defane/FPV-5.8-Checkoint/docs/fleet.md

# Race-timing fleet (C6 master)

For a multi-gate race, an **ESP32-C6 master** (`firmware/master`) takes over the
C3's brain role and carries the speaker. Each **gate** is a C5; the master's C5
is UART-wired to the C6 (gate 0), the others are each wired to a **C3 node** that
relays over **ESP-NOW** to the C6.

Overall element/interaction diagram: [`fleet.svg`](fleet.svg). Pin-level wiring
per set type: [`wiring-master.svg`](wiring-master.svg) (C6 + C5),
[`wiring-node.svg`](wiring-node.svg) (C3 + C5; also a C3 + C5 with no master),
[`wiring-c5c5.svg`](wiring-c5c5.svg) (temporary C5+C5). Only the master carries
an amplifier; a gate C5 never does. Consolidated pinout: the
[README](../README.md#pinout).

**Temporary C5+C5 set** (until a C6 is available): a second C5 runs the master
firmware built for esp32c5 (`firmware/master`, target esp32c5). The amp moves to
the C5 pins 9/8/7/10 (GPIO 16‑22 are the C5 flash); UART stays 4/5. Build: `make
flash FW=master-wave-c5` (or `idf.py -DIDF_TARGET=esp32c5 -DSDKCONFIG=sdkconfig.c5
-DSDKCONFIG_DEFAULTS=sdkconfig.c5.defaults -B build-c5 build` from
`firmware/master`, → `build-c5/master-c5.bin`). Later swap that C5 for a real C6
with no change on the gate side.

- **Protocols:** `components/link_proto` v3 (C5↔bridge UART: `CONFIG_*`,
  `EVENT_PASS` with the pass's age, `STATS` with the 8 channels' levels and the C5's
  health, `COMMAND`); `components/fleet_proto` v3
  (C6↔C3 ESP-NOW: pairing, time beacons, `CONFIG`, `GATE_PASS`, `NODE_STATUS`
  relaying that, `COMMAND`); `components/espnow_link` (transport);
  `components/race_timing` (laps/sectors per channel). A board left on an older
  firmware is not misread, it simply does not talk: **reflash every C5, C3 and the
  C6 together** after a protocol change.
- **C6** (`c6_hub`): node table in NVS, periodic time beacons, the `race_timing`
  engine, **centralized sound**, and an **admin web** (AP) to pair, order the
  gates and see the timings. Every C5 sweeps R1 to R8, so a gate has no channel: a pass
  carries the channel it was seen on.
- **Pairing:** C6 web → *pairing open*; an unpaired C3 broadcasts a
  `PAIR_REQUEST`; the C6 assigns it a gate (`PAIR_ACCEPT` + `CONFIG`),
  persisted on both sides. The channel those frames still carry is ignored. A node only asks
  while it boots, so with pairing closed it ends up degraded: open pairing, then reboot it.
- **Degraded C3:** if the C6 is unreachable for `CONFIG_C3_FLEET_TIMEOUT_MS` at
  boot, the C3 serves its own local AP + web (pass display, the channels' levels,
  detector settings).
- **Simple and advanced:** the C6 page opens on what spectators came for, the standings
  and the last results. Each channel in the standings has its status: online while a pass is under 30 s old, else offline; hover or tap the badge
  for when it was last seen, on the master's clock. The advanced toggle adds the channels, the gates
  and the race controls; the choice stays on the device (browser storage). It changes
  the view only: the admin password still guards every action.
- **Last results** (both views, `GET /api/results`): a column per channel seen, with
  its last 10 laps, newest on top. A click on a row adds the lap numbers and the sectors
  gate to gate (`G0→1`, `G1→2`, then `G2→0` closing the lap); `—` next to a gate that
  missed the drone. The pause toggle holds the table for that viewer, with a badge per
  channel counting the laps it is behind (`reset` if the channel was reset meanwhile)
  until it is released. An admin can reset one channel (`POST /api/reset` `{"channel": N}`):
  its times and its lap in progress go, it stays listed with when it was last seen.
  *Reset all* (`{}`) clears the whole race, standings included.
- **Channels panel:** the C6 page shows one row per gate, the degraded C3 page one
  tile per channel, R1 to R8, with its level in dB above the channel's rest and a yellow
  mark on a pass; `—` while the C5 is away or calibrating. A VTX left on keeps showing.
- **Web roles:** two levels. A **spectator** sees timings/status read-only (no
  login); **admin** actions (pairing, gate order, reset, volume, a
  gate's calibration or reboot; detector tuning on a degraded
  C3) need the admin password (`CONFIG_*_ADMIN_PASSWORD`, no
  username, any length): the header's admin toggle opens a password
  dialog; turning it off forgets it. An empty password disables
  admin auth. See "Signed admin requests" below.
- **Signed admin requests** (`components/web_auth`): the password never crosses
  the Wi-Fi and the firmware never holds it. The build turns it into
  K = PBKDF2-HMAC-SHA256(password, salt, 200000), 32 bytes in `admin_hash.h`,
  with a salt `fpv58-checkpoint/<c3|c6>/<16 hex>` random at each configure
  (`components/web_auth/project_include.cmake`, `admin_key.py`). At login the page
  opens a session (`POST /api/session`: a random 128-bit id from the hardware RNG,
  plus the salt and the iterations) and derives the same K from the typed password
  (`/auth.js`, pure-JS SHA-256/HMAC/PBKDF2, since browsers keep `crypto.subtle` for
  HTTPS: about 0.1 s on a desktop, 0.3–1 s on a phone, once per login, the dialog
  showing "checking…"; the ESP never runs the derivation). Every admin request
  then carries `X-Auth-Session`,
  `X-Auth-Seq` (1, 2, 3… per session) and `X-Auth-Sig` = HMAC-SHA256(K, sid `\n`
  seq `\n` method `\n` path `\n` body). The ESP accepts each seq once and only in
  increasing order, so a captured request replayed, or one with a changed body or
  path, is refused. Sessions live in RAM (4, least recently used evicted): after
  an ESP reboot the page reopens one with K, without asking for the password
  again. The page sends one request at a time and gives up on each HTTP exchange
  after 10 s (one that must reopen its session can take up to 30 s). On logout,
  or when the login dialog is closed during a login, queued requests are dropped;
  one already sent may still have run on the ESP and its reply reaches its
  caller, but nothing started before the logout is re-signed or retried after
  it, and a late refusal no longer logs the next login out. Limits:
  - a listener on the AP (it shares one Wi-Fi password with every spectator, or
    is open) who captures a single signed request, and every login sends one, can
    test password guesses offline; PBKDF2 makes each guess cost 200000 HMACs, but
    a short or common password still falls: use a long random one (the default
    `checkpoint` is public);
  - plain HTTP still lets an *active* attacker on the AP serve a modified page
    that reads the password as it is typed (only HTTPS prevents that);
  - anyone with the `.bin` holds K and can sign without the password;
  - anyone on the AP can force sessions to be reopened.
- **Constraint:** the C6 and C3 APs **and** ESP-NOW share the **same Wi-Fi
  channel** (`CONFIG_*_AP_CHANNEL` / `CONFIG_C6_AP_CHANNEL`).
- **Limit:** the time base (ESP-NOW beacons) aims for ~10 ms; not a sub-ms photo
  finish. A pass is timed at its peak by the C5, and a lap by gate 0's C5 alone. A sector
  also depends on when a remote gate's pass reaches its C3, after a 100 ms UART poll
  (`LINK_READ_MS`): count ±0.1 s on it for now. The first passes after a boot teach the
  master the local C5's clock, so a lap there can read a little short.

## Gate health and remote commands (no console in production)

Nobody opens a detector C5's USB console in production, so everything an operator
needs from it goes through its bridge: the C6 admin web for the fleet (gate 0 is
its own C5 over UART, the others go through their C3), or the degraded C3's own
page for a gate with no master.

- **Health**, from the C5's `STATS` every `CONFIG_CHECKPOINT_LINK_STATS_MS`
  (relayed in `NODE_STATUS`): a calibration badge (OK / calibration needed, i.e.
  `CAL_NEEDED`/`DC_FAULT` / calibrating), RX gain, passes since boot, C5 uptime,
  lowest free heap, transport fault counters and the firmware id. A C5 silent for
  **3 s** is shown as absent: no stale health, and commands to it fail.
- **Commands** (admin): *Cal B* = the console's `B` (full RF optimisation),
  *Cal F* = `F` (quick filter calibration), *Reboot*; on the C6 also *Calibrate
  all gates (B)*. They call the same engine functions as the console
  (`filter_request_full()`, `filter_request()`), so the engine still refuses a
  calibration that is already running.
- **Guard:** a calibration blinds the gate for minutes and wants the VTXs off.
  The page asks for confirmation; then the bridge refuses, unless forced, any
  gate whose strongest channel is above that C5's activity threshold (`active_db`,
  read from its `CONFIG_STATE` echo), i.e. a VTX is probably on. The C6 also skips gates
  already calibrating (listed as *busy*); the C3 page disables its calibration
  buttons meanwhile. Reboot is not VTX-guarded.
- **API:** C6 `POST /api/command` `{"gate": 0..15 | -1 (all), "cmd": "cal_full" |
  "cal_quick" | "reboot", "force": 0|1}` → `{"ok": true, "sent": [...], "failed":
  [...], "busy": [...]}` or `{"ok": false, "vtx": [{"gate": g, "cn_x10": x}]}`. The
  degraded C3's `POST /api/command` `{"cmd": ..., "force": 0|1}` (its one gate)
  replies `{"ok": true}`, `{"ok": false, "vtx": true, "cn_x10": x}` or
  `{"ok": false, "msg": "no C5 linked"}`.
- **Back online:** the C6 re-sends a node's `CONFIG` (gate, detector settings) when the
  node comes back online, so a rebooted gate returns to its assignment.
