defane/FPV-5.8-Checkoint/hardware/checkpoint-master/checkpoint-master-1to1.pdf

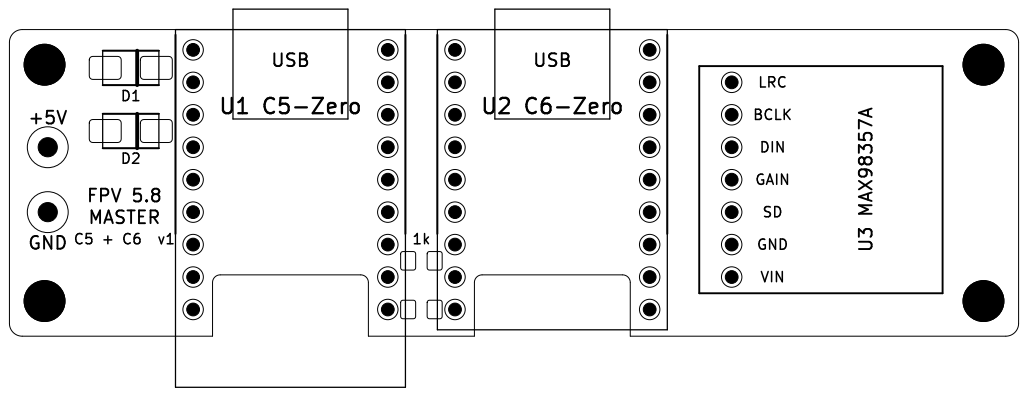
[picture p2: page 1]
