defane/FPV-5.8-Checkoint/hardware/checkpoint-node/checkpoint-node-1to1.pdf

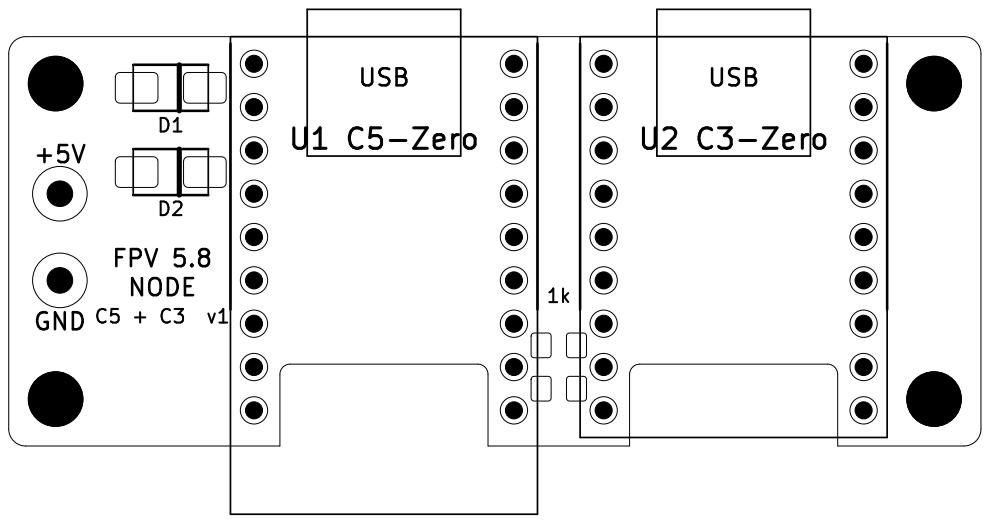
[picture p3: page 1]
