defane/FPV-5.8-Checkoint/hardware/checkpoint-node/checkpoint-node.kicad_pcb

## KiCad design hardware/checkpoint-node/checkpoint-node.kicad_pcb (2026-11-07)

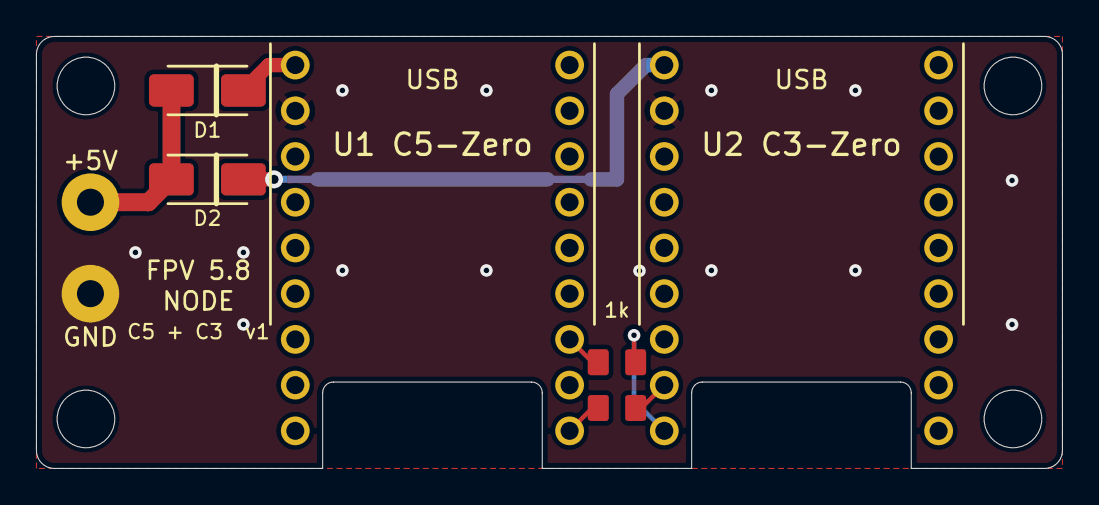
[picture p4: board checkpoint-node.kicad_pcb from above]

Board: 2 copper layers, 57.0 x 24.0 mm, 12 parts (0 on the bottom side), 8 nets.

Parts:
D1, D2: SS34 3A 40V SMA; SS34
H1, H2, H3, H4: M3 hole; M3
J1: +5V wire pad; +5V
J2: GND wire pad; GND
R1, R2: 1k 0805; 1k
U1: C5-Zero
U2: C3-Zero

Connections:
5V_BRIDGE: D2.1, U2.5V
5V_C5: D1.1, U1.5V
+5V: D1.2, D2.2, J1.1
BRIDGE_RX: R1.2, U2.4
BRIDGE_TX: R2.2, U2.5
C5_RX: R2.1, U1.8
C5_TX: R1.1, U1.6
GND: J2.1, U1.GND, U2.GND
