defane/FPV-5.8-Checkoint/firmware/master/main/c6_web.c

#include "c6_web.h"
#include "admin_hash.h"
#include "c6_hub.h"
#include "c6_store.h"
#include "esp_http_server.h"
#include "esp_log.h"
#include "sdkconfig.h"
#include "web_auth_esp.h"
#include <stdio.h>
#include <stdlib.h>
#include <string.h>

static const char *TAG = "c6_web";

extern const uint8_t index_html_start[] asm("_binary_index_html_start");
extern const uint8_t index_html_end[]   asm("_binary_index_html_end");

static esp_err_t get_root(httpd_req_t *req) {
    httpd_resp_set_type(req, "text/html");
    return httpd_resp_send(req, (const char *)index_html_start,
                           index_html_end - index_html_start - 1);
}

/* Snapshots for the handlers: too large for the httpd stack (c6_fleet_t is
 * ~1.5 KB), and httpd runs one handler at a time. */
static c6_snapshot_t s_snap;
static c6_fleet_t    s_fleet;
static race_timing_t s_results;

/* A C5's firmware id is foreign text: keep it inert in the JSON and in the
 * page's HTML (printable ASCII minus quotes, backslash and markup). */
static const char *safe_fw(const char *fw, char out[LP_FW_LEN]) {
    unsigned i = 0;
    for (; i + 1u < LP_FW_LEN && fw[i]; i++)
        out[i] = (fw[i] >= 0x20 && fw[i] < 0x7f && !strchr("\"\\<>&'", fw[i])) ? fw[i] : '?';
    out[i] = '\0';
    return out;
}

/* The C5 health fields shared by "local" and each node. */
static int put_health(char *b, size_t cap, uint32_t passes, uint8_t flags, uint8_t gain,
                      uint32_t uptime_s, uint32_t heap_min, uint32_t faults, const char *fw) {
    char f[LP_FW_LEN];
    return snprintf(b, cap, "\"passes\":%lu,\"cal_needed\":%s,\"calibrating\":%s,\"gain\":%u,"
                    "\"c5_uptime_s\":%lu,\"heap_min\":%lu,\"faults\":%lu,\"fw\":\"%s\"",
                    (unsigned long)passes, (flags & LP_HEALTH_CAL_NEEDED) ? "true" : "false",
                    (flags & LP_HEALTH_CALIBRATING) ? "true" : "false", gain,
                    (unsigned long)uptime_s, (unsigned long)heap_min, (unsigned long)faults,
                    safe_fw(fw, f));
}

/* One level per Raceband channel, dB x10, LP_CN_UNKNOWN when not measured. */
static int put_levels(char *b, size_t cap, const int8_t *levels) {
    int o = snprintf(b, cap, "\"levels\":[");
    for (unsigned ch = 0; ch < LP_LEVELS; ch++) {
        const bool known = levels && levels[ch] != LP_LEVEL_UNKNOWN;
        o += snprintf(b + o, cap - o, "%s%d", ch ? "," : "", known ? levels[ch] * 10 : LP_CN_UNKNOWN);
    }
    return o + snprintf(b + o, cap - o, "],");
}

static esp_err_t get_state(httpd_req_t *req) {
    c6_store_snapshot(&s_snap);
    c6_hub_snapshot(&s_fleet);
    const c6_snapshot_t *s = &s_snap;
    const c6_fleet_t *f = &s_fleet;

    /* Worst case (every field at its widest) 9996 B: levels 59 x 16 gates, last_seen_ms
     * 25 x 8 standings, header + local 394,
     * 15 nodes x 392, 8 standings 838, 24 passes 1739; sized so it never truncates. */
    static char body[10240];   /* larger than the stack; this handler is serialised by httpd */
    const lp_stats_t *l = &s->local;
    int o = 0;
    o += snprintf(body + o, sizeof body - o,
                  "{\"pairing\":%s,\"num_gates\":%u,\"has_local\":%s,"
                  "\"local\":{\"channel\":%u,\"cn_x10\":%ld,\"state\":%u,",
                  f->pairing ? "true" : "false", f->num_gates, s->has_local ? "true" : "false",
                  l->channel, (long)l->cn_x10, l->state);
    o += put_levels(body + o, sizeof body - o, s->has_local ? l->levels : NULL);
    o += put_health(body + o, sizeof body - o, l->passes, l->flags, l->gain, l->uptime_s,
                    l->heap_min, l->faults, l->fw);
    o += snprintf(body + o, sizeof body - o,
                  "},\"total_passes\":%lu,\"volume\":%u,"
                  "\"uptime_ms\":%lu,\"free_heap\":%lu,\"heap_total\":%lu,",
                  (unsigned long)s->total_passes, (unsigned)f->volume,
                  (unsigned long)f->uptime_ms, (unsigned long)f->free_heap,
                  (unsigned long)f->heap_total);

    o += snprintf(body + o, sizeof body - o, "\"nodes\":[");
    for (unsigned i = 0; i < f->num_nodes && o < (int)sizeof body; i++) {
        const c6_node_t *n = &f->nodes[i];
        o += snprintf(body + o, sizeof body - o,
                      "%s{\"node_id\":%u,\"gate\":%u,\"channel\":%u,\"online\":%s,\"cn_x10\":%ld,"
                      "\"state\":%u,\"last_seen_ms\":%lu,\"rssi\":%d,\"rx_frames\":%lu,"
                      "\"status_rx\":%lu,\"status_lost\":%lu,"
                      "\"mac\":\"%02x:%02x:%02x:%02x:%02x:%02x\",",
                      i ? "," : "", n->node_id, n->gate_index, n->channel,
                      n->online ? "true" : "false", (long)n->cn_x10,
                      n->state, (unsigned long)n->last_seen_ms,
                      (int)n->rssi, (unsigned long)n->rx_frames,
                      (unsigned long)n->status_rx, (unsigned long)n->status_lost,
                      n->mac[0], n->mac[1], n->mac[2], n->mac[3], n->mac[4], n->mac[5]);
        o += put_levels(body + o, sizeof body - o, n->online ? n->levels : NULL);
        o += put_health(body + o, sizeof body - o, n->passes, n->flags, n->gain, n->c5_uptime_s,
                        n->heap_min, n->faults, n->fw);
        o += snprintf(body + o, sizeof body - o, "}");
    }
    o += snprintf(body + o, sizeof body - o, "],\"standings\":[");
    for (unsigned i = 0; i < f->num_standings && o < (int)sizeof body; i++) {
        const c6_standing_t *st = &f->standings[i];
        o += snprintf(body + o, sizeof body - o,
                      "%s{\"channel\":%u,\"laps\":%lu,\"last_lap_ms\":%lu,\"best_lap_ms\":%lu,\"last_gate\":%d,"
                      "\"last_seen_ms\":%lu}",
                      i ? "," : "", st->channel, (unsigned long)st->laps,
                      (unsigned long)st->last_lap_ms, (unsigned long)st->best_lap_ms, st->last_gate,
                      (unsigned long)st->last_seen_ms);
    }
    o += snprintf(body + o, sizeof body - o, "],\"passes\":[");
    for (unsigned i = 0; i < s->n_passes && o < (int)sizeof body; i++)
        o += snprintf(body + o, sizeof body - o,
                      "%s{\"gate\":%u,\"channel\":%u,\"peak_db_x10\":%ld,\"at_ms\":%lu}",
                      i ? "," : "", s->passes[i].gate, s->passes[i].channel,
                      (long)s->passes[i].peak_db_x10, (unsigned long)s->passes[i].at_ms);
    o += snprintf(body + o, sizeof body - o, "]}");

    httpd_resp_set_type(req, "application/json");
    return httpd_resp_send(req, body, o);
}

/* Each channel's last laps, a chunk per channel: 8 full ones reach 18 KB. */
static esp_err_t get_results(httpd_req_t *req) {
    c6_hub_results(&s_results);
    const race_timing_t *rt = &s_results;
    /* Worst chunk (16 gates, every number at its widest) 2244 B: header 28, channel 24,
     * 10 laps x 219, closing 2; sized so it never truncates. */
    static char body[2304];   /* larger than the stack; this handler is serialised by httpd */
    httpd_resp_set_type(req, "application/json");
    int o = snprintf(body, sizeof body, "{\"num_gates\":%u,\"channels\":[", rt->cfg.num_gates);
    for (unsigned i = 0; i < rt->num_channels; i++) {
        const rt_channel_t *c = &rt->ch[i];
        o += snprintf(body + o, sizeof body - o, "%s{\"channel\":%u,\"laps\":[", i ? "," : "", c->channel);
        const rt_lap_t *lap;
        for (unsigned age = 0; (lap = rt_recent_lap(c, age)) != NULL; age++) {
            o += snprintf(body + o, sizeof body - o, "%s{\"number\":%lu,\"lap_ms\":%lu,\"splits\":[",
                          age ? "," : "", (unsigned long)lap->number, (unsigned long)lap->lap_ms);
            for (unsigned g = 1; g < rt->cfg.num_gates; g++)
                o += snprintf(body + o, sizeof body - o, "%s%lu", g > 1 ? "," : "", (unsigned long)lap->split_ms[g]);
            o += snprintf(body + o, sizeof body - o, "]}");
        }
        o += snprintf(body + o, sizeof body - o, "]}");
        if (httpd_resp_send_chunk(req, body, o) != ESP_OK) return ESP_FAIL;
        o = 0;
    }
    o += snprintf(body + o, sizeof body - o, "]}");
    if (httpd_resp_send_chunk(req, body, o) != ESP_OK) return ESP_FAIL;
    return httpd_resp_send_chunk(req, NULL, 0);
}

/* Tiny parser for the flat integer objects our own client POSTs. */
static int32_t json_i(const char *body, const char *key, int32_t def) {
    char pat[40];
    snprintf(pat, sizeof pat, "\"%s\"", key);
    const char *p = strstr(body, pat);
    if (!p) return def;
    p = strchr(p + strlen(pat), ':');
    if (!p) return def;
    p++;
    while (*p == ' ' || *p == '\t') p++;
    char *end;
    const long v = strtol(p, &end, 10);
    return end == p ? def : (int32_t)v;
}

/* Same for a "key":"value" string; false if absent or longer than out[cap]. */
static bool json_s(const char *body, const char *key, char *out, size_t cap) {
    char pat[40];
    snprintf(pat, sizeof pat, "\"%s\"", key);
    const char *p = strstr(body, pat);
    if (!p || !(p = strchr(p + strlen(pat), ':'))) return false;
    p++;
    while (*p == ' ' || *p == '\t') p++;
    if (*p++ != '"') return false;
    size_t n = 0;
    while (*p && *p != '"' && n + 1u < cap) out[n++] = *p++;
    out[n] = '\0';
    return *p == '"';
}

static esp_err_t ok_json(httpd_req_t *req, bool ok) {
    httpd_resp_set_type(req, "application/json");
    return httpd_resp_sendstr(req, ok ? "{\"ok\":true}" : "{\"ok\":false}");
}

/* ---- admin auth (spectators are read-only; admin actions are signed) ---- */
/* Every admin request is signed in the page with K = PBKDF2(password, ADMIN_SALT,
 * ADMIN_ITERATIONS), the only form of the password the firmware holds (admin_hash.h,
 * generated at build time by web_auth_admin_key()); components/web_auth checks the signature,
 * the session and its replay counter. web_auth_request() also reads the body:
 * on false its 400/401 is already sent. */
static const uint8_t s_admin_key[] = ADMIN_KEY;

static esp_err_t get_auth(httpd_req_t *req) {
    char buf[8];
    if (!web_auth_request(req, buf, sizeof buf)) return ESP_OK;
    httpd_resp_set_type(req, "application/json");
    return httpd_resp_sendstr(req, "{\"admin\":true}");
}

static esp_err_t post_pairing(httpd_req_t *req) {
    char buf[128];
    if (!web_auth_request(req, buf, sizeof buf)) return ESP_OK;
    c6_hub_set_pairing(json_i(buf, "open", 0) != 0);
    return ok_json(req, true);
}

static esp_err_t post_node(httpd_req_t *req) {
    char buf[128];
    if (!web_auth_request(req, buf, sizeof buf)) return ESP_OK;
    bool ok = c6_hub_set_node((uint8_t)json_i(buf, "node_id", -1),
                              (uint8_t)json_i(buf, "gate", 0),
                              (uint8_t)json_i(buf, "channel", 0));
    return ok_json(req, ok);
}

static esp_err_t post_node_remove(httpd_req_t *req) {
    char buf[128];
    if (!web_auth_request(req, buf, sizeof buf)) return ESP_OK;
    return ok_json(req, c6_hub_remove_node((uint8_t)json_i(buf, "node_id", -1)));
}

static esp_err_t post_reset(httpd_req_t *req) {
    char buf[16];   /* "{}" for the race, {"channel":255} for one: signed like any body */
    if (!web_auth_request(req, buf, sizeof buf)) return ESP_OK;
    const int32_t channel = json_i(buf, "channel", -1);
    if (channel >= 0) return ok_json(req, c6_hub_reset_channel((uint8_t)channel));
    c6_hub_reset_race();
    return ok_json(req, true);
}

static esp_err_t post_volume(httpd_req_t *req) {
    char buf[128];
    if (!web_auth_request(req, buf, sizeof buf)) return ESP_OK;
    c6_hub_set_volume((uint8_t)json_i(buf, "volume", 60));
    return ok_json(req, true);
}

/* A JSON array of the gates set in mask. */
static int put_gates(char *b, size_t cap, uint32_t mask) {
    int o = snprintf(b, cap, "[");
    for (unsigned g = 0; g < RT_MAX_GATES; g++)
        if (mask >> g & 1u)
            o += snprintf(b + o, cap - o, "%s%u", (mask & ((1u << g) - 1u)) ? "," : "", g);
    return o + snprintf(b + o, cap - o, "]");
}

static const struct { const char *name; lp_cmd_t cmd; } k_cmds[] = {
    { "cal_full", LP_CMD_CAL_FULL }, { "cal_quick", LP_CMD_CAL_QUICK }, { "reboot", LP_CMD_REBOOT },
};

/* The C5 console's B / F / reset for gates nobody plugs USB into.
 * {"gate":0..15, -1 = every reachable gate, "cmd":"cal_full"|"cal_quick"|"reboot",
 * "force":0|1}. A calibration blinds the gate for its duration and wants every
 * VTX off: unless forced, a target already seeing a C/N above its active_db (a
 * VTX probably on) blocks the whole request and is listed in "vtx" for the admin
 * to confirm and force. Otherwise each target goes to "sent" or "failed", and
 * for a calibration a gate already calibrating (its C5 would refuse, on its USB
 * console only) is not sent but listed in "busy". */
static esp_err_t post_command(httpd_req_t *req) {
    char buf[128], name[16];
    if (!web_auth_request(req, buf, sizeof buf)) return ESP_OK;
    const int32_t gate = json_i(buf, "gate", -2);
    lp_cmd_t cmd = 0;
    if (json_s(buf, "cmd", name, sizeof name))
        for (unsigned i = 0; i < sizeof k_cmds / sizeof k_cmds[0]; i++)
            if (strcmp(name, k_cmds[i].name) == 0) cmd = k_cmds[i].cmd;
    if (!cmd || gate < -1 || gate >= (int32_t)RT_MAX_GATES) {
        httpd_resp_send_err(req, HTTPD_400_BAD_REQUEST, "cmd/gate"); return ESP_FAIL;
    }

    /* Targets as a gate mask (a gate shared by two nodes is one target), the
     * strongest C/N each one sees now and the gates already calibrating; an
     * offline node's or an absent local C5's last C/N and flags are stale (an
     * absent gate 0 asked by name lands in "failed"). */
    c6_store_snapshot(&s_snap);
    c6_hub_snapshot(&s_fleet);
    int32_t cn[RT_MAX_GATES];
    for (unsigned g = 0; g < RT_MAX_GATES; g++) cn[g] = LP_CN_UNKNOWN;
    uint32_t busy = 0;
    if (s_snap.has_local) {
        cn[0] = s_snap.local.cn_x10;
        if (s_snap.local.flags & LP_HEALTH_CALIBRATING) busy |= 1u;
    }
    uint32_t targets = (gate == 0 || (gate == -1 && s_snap.has_local)) ? 1u : 0u;
    bool known = gate <= 0;                    /* gate 0 is always the master's own */
    for (unsigned i = 0; i < s_fleet.num_nodes; i++) {
        const c6_node_t *n = &s_fleet.nodes[i];
        if (n->gate_index >= RT_MAX_GATES) continue;
        if (n->gate_index == gate) { known = true; targets |= 1u << gate; }
        if (!n->online) continue;
        if (gate == -1) targets |= 1u << n->gate_index;
        if (n->cn_x10 > cn[n->gate_index]) cn[n->gate_index] = n->cn_x10;
        if (n->flags & LP_HEALTH_CALIBRATING) busy |= 1u << n->gate_index;
    }
    if (!known) { httpd_resp_send_err(req, HTTPD_400_BAD_REQUEST, "gate"); return ESP_FAIL; }
    busy = cmd == LP_CMD_REBOOT ? 0u : busy & targets;   /* a reboot still reaches a busy C5 */
    targets &= ~busy;

    char out[640];   /* worst case: 16 vtx entries x 34 B */
    int o;
    uint32_t vtx = 0;
    /* Gate 0's own C5 tells its active_db; remote gates run the one the hub pushes. */
    const int32_t vtx_x10 = c6_hub_vtx_threshold_x10();
    const int32_t vtx0_x10 = s_snap.has_local_cfg ? s_snap.local_cfg.active_db_x10 : vtx_x10;
    if (cmd != LP_CMD_REBOOT && json_i(buf, "force", 0) == 0)
        for (unsigned g = 0; g < RT_MAX_GATES; g++)
            if ((targets >> g & 1u) && cn[g] != LP_CN_UNKNOWN && cn[g] > (g ? vtx_x10 : vtx0_x10))
                vtx |= 1u << g;
    if (vtx) {
        o = snprintf(out, sizeof out, "{\"ok\":false,\"vtx\":[");
        for (unsigned g = 0; g < RT_MAX_GATES; g++)
            if (vtx >> g & 1u)
                o += snprintf(out + o, sizeof out - o, "%s{\"gate\":%u,\"cn_x10\":%ld}",
                              (vtx & ((1u << g) - 1u)) ? "," : "", g, (long)cn[g]);
        o += snprintf(out + o, sizeof out - o, "]}");
        ESP_LOGW(TAG, "command %s gate %ld held: strong signal on gates 0x%04lx", name, (long)gate,
                 (unsigned long)vtx);
    } else {
        uint32_t sent = 0, failed = 0;
        for (unsigned g = 0; g < RT_MAX_GATES; g++)
            if (targets >> g & 1u) {
                if (c6_hub_send_command((uint8_t)g, cmd)) sent |= 1u << g;
                else failed |= 1u << g;
            }
        o = snprintf(out, sizeof out, "{\"ok\":true,\"sent\":");
        o += put_gates(out + o, sizeof out - o, sent);
        o += snprintf(out + o, sizeof out - o, ",\"failed\":");
        o += put_gates(out + o, sizeof out - o, failed);
        o += snprintf(out + o, sizeof out - o, ",\"busy\":");
        o += put_gates(out + o, sizeof out - o, busy);
        o += snprintf(out + o, sizeof out - o, "}");
        ESP_LOGI(TAG, "command %s gate %ld: sent 0x%04lx failed 0x%04lx busy 0x%04lx", name,
                 (long)gate, (unsigned long)sent, (unsigned long)failed, (unsigned long)busy);
    }
    httpd_resp_set_type(req, "application/json");
    return httpd_resp_send(req, out, o);
}

void c6_web_start(void) {
    web_auth_init(s_admin_key, ADMIN_SALT, ADMIN_ITERATIONS, ADMIN_AUTH_OPEN);
    httpd_config_t cfg = HTTPD_DEFAULT_CONFIG();
    cfg.lru_purge_enable = true;
    cfg.max_uri_handlers = 12;   /* 10 here + web_auth's 2 */
    cfg.stack_size = 6144;       /* the signature's PSA HMAC under post_command: ~3.5 KB of the 4 KB default */
    httpd_handle_t srv = NULL;
    if (httpd_start(&srv, &cfg) != ESP_OK) { ESP_LOGE(TAG, "httpd start failed"); return; }
    const httpd_uri_t uris[] = {
        { .uri = "/",             .method = HTTP_GET,  .handler = get_root },
        { .uri = "/api/state",    .method = HTTP_GET,  .handler = get_state },
        { .uri = "/api/results",  .method = HTTP_GET,  .handler = get_results },
        { .uri = "/api/auth",     .method = HTTP_GET,  .handler = get_auth },
        { .uri = "/api/pairing",  .method = HTTP_POST, .handler = post_pairing },
        { .uri = "/api/node",     .method = HTTP_POST, .handler = post_node },
        { .uri = "/api/node_remove", .method = HTTP_POST, .handler = post_node_remove },
        { .uri = "/api/reset",    .method = HTTP_POST, .handler = post_reset },
        { .uri = "/api/volume",   .method = HTTP_POST, .handler = post_volume },
        { .uri = "/api/command",  .method = HTTP_POST, .handler = post_command },
    };
    for (unsigned i = 0; i < sizeof uris / sizeof uris[0]; i++) httpd_register_uri_handler(srv, &uris[i]);
    web_auth_register(srv);   /* POST /api/session, GET /auth.js */
    ESP_LOGI(TAG, "admin web on http://192.168.4.1/");
}
