defane/FPV-5.8-Checkoint/(commit log)

2026-10-29 feat(audio): add reproducible coin sound conversion
    tools/coin_sound.py turns assets/coin_source.mp3 (Pixabay, KRNBEATZ,
    not versioned) into mono 22050 Hz s16le PCM: silence trimmed, 2 ms
    fade-in, 10 ms fade-out, peak-normalised to -3 dBFS in a second pass.
    --check verifies the committed PCM.
2026-10-29 feat(audio_player): add low-priority I2S coin player
    New isolated component: MAX98357A on i2s_std, mono 22050 Hz s16, one
    priority-1 task fed by a queue of at most two requests (oldest dropped),
    per-request pitch by linear-interpolation resampling, software volume
    (60 % default), mute, SD high before a sound and low 50 ms after.
    The I2S channel (and its GDMA TX channel) is created per burst of sounds
    and deleted afterwards: transport.c's quiet_interrupts() disables the
    interrupts of all three GDMA channels on every transport restart, which
    would otherwise stall a long-lived I2S channel. No allocation while
    samples are written; the PCM is read from flash.
    Disabled by default (CONFIG_AUDIO_P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
    [audio_player.c, audio_player.h, audio_resample.h, test_audio_resample.c]
2026-10-29 feat(detector): add per-channel drone pass detector
    Pure C component (no hardware): exponential smoothing and an
    IDLE -> RISING -> PEAK_PASSED -> COOLDOWN machine per channel. A pass
    rings when the level falls drop_db (3 dB) under its maximum and that
    maximum reached min_peak_db; per-channel refractory period (1.5 s) and
    re-arm only once the level is back under the activity threshold minus
    hysteresis, so a hovering drone rings once. Stale channels return to
    IDLE. All thresholds in one pd_config_t.
    Host test test/test_pass_detector.c (in CI): clean and noisy pass,
    two drones on two channels, hovering drone, noise under the threshold,
    far drone, two laps, refractory, stale input, ms wraparoun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
    [test_pass_detector.c]
2026-10-29 feat: integrate pass detection on the tuned channel
    main/checkpoint.c: a priority-1 task (under every receiver task) reads
    the noise-referenced C/N (receiver_obs_cn_x10, dB) every 50 ms, feeds
    the pass detector with the tuned channel's number in its band and
    prints a PASS line per pass; with an audio build it queues the coin at
    that channel's pentatonic pitch. No sample while the menu, scan,
    calibration or a pause owns the receiver, or while the C/N is unknown;
    a retune resets the detector. Read-only on the receiver chain.
    Started after the boot splash with heap state, so nothing is added to
    the ~2 KB boot memory peak. The audio build refuses amplifier pins the
    receiver owns (IQ loopback fr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
    [audio_player.c, checkpoint.c, checkpoint.h, main.c]
2026-10-29 feat(console): add checkpoint play, mute and detector keys
    P plays the coin at the tuned channel's pitch, p toggles the sound, K
    opens a 5 s settings window (re-armed per key, q closes) like S:
    a/A alpha, t/T activity threshold, h/H hysteresis, d/D drop,
    m/M minimum peak, r/R refractory, v/V volume, l live C/N trace,
    0 defaults, k show. Settings and mute are kept in NVS "checkpoint";
    the task picks up new thresholds under a spinlock. T prints a
    CHECKPOINT status line; h lists the new keys.
2026-10-29 docs: document checkpoint wiring, pins, detector and bench test
    CLAUDE.md: priorities, current amplifier wiring and its IQ-loopback
    conflict, full GPIO ownership map, GDMA use, detector parameters,
    build and test commands. docs/CHECKPOINT.md: behaviour, console keys
    and the bench procedure, including an A/B/A reception comparison with
    audio idle and active (tools/checkpoint_bench.py, built on
    field_diag_compare.py). README: C5VRX attribution required by
    AGENTS.md for a derivative.
2026-10-29 feat(transport): make the video DAC output optional, off here
    CONFIG_C5VRX_VIDEO_OUTPUT (default y, upstream behaviour) routes the
    6-bit DAC. This project only plays a sound, so sdkconfig.defaults sets
    it to n: transport.c's s_dac_gpio becomes all -1, PARLIO TX and the
    BitScrambler run unchanged at the same timing but drive no pin. The IQ
    capture and everything measured from it are untouched.
    The checkpoint pin check then accepts the DAC pins (8, 9, 11, 12, 23,
    24) and 7/10 for the amplifier; SD is refused on strapping GPIO7; the
    IQ loopback pins stay forbidden. Docs updated.
    Approved by the operator ("on veut pas de sortie vidéo").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
2026-10-29 feat(audio_player): default amplifier pins to GPIO 9/8/7/10
    With the video output off, the amplifier moves to freed pins: BCLK
    GPIO9, LRC GPIO8, DIN GPIO7, SD GPIO10. SD stays off strapping GPIO7;
    only the high-impedance DIN input sits there. The first wiring
    (GPIO1/3/4/5) was on the IQ loopback and is dropped from the docs.
2026-10-30 refactor: move C5 firmware to firmware/c5 with shared components/
    Move the ESP32-C5 project (build root + main/) into firmware/c5/ while
    keeping the reusable components at the repository root, so a second
    firmware target (ESP32-C3) can share them. The C5 build adds
    EXTRA_COMPONENT_DIRS pointing at ../../components.
    Pure file moves (git renames); no receive-chain logic changed. Build stays
    at 0 warnings and both host tests pass from the new layout.
    [partitions.csv]
2026-10-30 refactor(c5vrx_rx): extract the C5VRX engine as a consumable component
    Move the upstream C5VRX receive chain, its control/calibration/diagnostics
    and the console out of firmware/c5/main into a components/c5vrx_rx component,
    and the checkpoint feature into its own components/checkpoint. firmware/c5/main
    is now just app_main consuming the two.
    The console and boot calls into checkpoint are kept without a circular
    dependency by weak no-op stubs (checkpoint_weak.c) in c5vrx_rx; the checkpoint
    component supplies the strong overrides (verified: all checkpoint_* resolve to
    libcheckpoint.a in the link map). c5vrx_rx thus also builds standalone as
    plain C5VRX with no sound.
    Pure file moves: no rece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
    [checkpoint.c, checkpoint.h, checkpoint_weak.c, console.c, transport.c]
2026-10-30 feat(link_proto): add the C5<->C3 UART protocol with a host test
    Pure-C, shared component for the two-ESP platform: a CRC16-framed message set
    (HELLO, CONFIG_SET/REQ/STATE, EVENT_PASS, STATS) with integer-only, little
    endian payloads so the C5 and C3 agree without float or struct-padding
    assumptions. The streaming decoder buffers one frame and rescans on a bad
    SOF/version/length/CRC, so noise or a truncated frame never swallows the next.
    test/test_link_proto.c covers roundtrips, buffer limits, resync after noise,
    CRC rejection, truncation recovery and unknown-type drop (13 checks).
    [link_proto.c, link_proto.h, test_link_proto.c]
2026-10-30 feat(checkpoint): report passes and accept config over the C3 UART link
    Add checkpoint_link.c: a priority-1 task that owns a UART (default GPIO 6 TX /
    15 RX, 115200, the only receiver-free pins) and speaks link_proto to the C3. It
    announces HELLO, streams STATS every second and an EVENT_PASS per detected
    pass, and applies CONFIG_SET / answers CONFIG_REQ, echoing the validated result
    as CONFIG_STATE.
    checkpoint.c gains the link accessors (apply/get config, get stats) that reuse
    its existing wanted/wanted_dirty + NVS path, and reports each pass through a
    queue so every UART write stays on the link task. A Kconfig menu gates the
    link and its pins/baud; off, checkpoint is sound-only as before.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
2026-10-30 feat(c3): add the ESP32-C3 config/telemetry bridge (UART + Wi-Fi + web)
    New firmware/c3 app: a Wi-Fi SoftAP and a small web UI that tune the C5's pass
    detector and show its live C/N, stats and recent pass events, over the
    link_proto UART.
    - c3_store: mutex-guarded authoritative config (persisted in NVS), latest stats
    and a 16-deep pass-event log.
    - c3_link: UART task; adopts the C5's config on a fresh C3, otherwise pushes the
    stored config (also on each C5 HELLO, so a C5 reboot re-syncs), and feeds
    incoming events/stats into the store.
    - c3_web: esp_http_server serving one embedded page plus GET /api/state and
    POST /api/config (parsed without a managed cJSON dependency).
    The build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
    [partitions.csv]
2026-10-30 refactor: repath upstream tests, tooling and CI to the new layout
    The engine moved to components/c5vrx_rx (and the build root to firmware/c5), so
    the upstream host tests, tooling and research scripts that referenced main/ at
    the repository root are repathed to components/c5vrx_rx (main.c, the only app
    file they touched, to firmware/c5/main). Targeted path-only edits: a git branch
    "origin/main" and a {'main': ...} dict key are left untouched.
    CI now builds firmware/c5 and firmware/c3, runs the link_proto host test, hashes
    the firmware inputs across components/ + firmware/c5/, and filters on firmware/**.
    Validated locally: the repathed C host tests compile and pass, and the
    runnable Python t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
2026-10-30 docs: document the two-ESP checkpoint platform
    Update CLAUDE.md, README.md and docs/CHECKPOINT.md for the restructure: the
    C5VRX engine as the components/c5vrx_rx component, firmware/c5 + firmware/c3,
    the C5<->C3 UART link (GPIO 6/15, link_proto) with the C3 as the authoritative
    config/telemetry bridge, and the per-firmware build commands.
2026-10-30 docs: add the C3/C5/amplifier wiring diagram (SVG + Graphviz source)
    docs/wiring.svg is a scalable wiring schematic of the platform; docs/wiring.dot
    is the Graphviz source that regenerates it (and a PNG via `dot -Tpng`). Both
    show the crossed UART link (C5 GPIO6/15 <-> C3 GPIO5/4), the I2S bus and SD
    enable to the MAX98357A (GPIO9/8/7/10), shared 5 V + common ground, and the
    4 Ohm speaker. Linked from docs/CHECKPOINT.md.
2026-10-30 chore: remove upstream C5VRX material not used by the platform
    Delete the C5VRX project artifacts the two-ESP sound platform does not use:
    - legacy/ (archived C5VRX-1..4 generations)
    - hardware/ and docs/hardware/ (resistor-DAC PCB and carrier designs)
    - web/ (online web flasher) and its CI: deploy-web.yml, web-checks.yml,
    tools/prepare_pages_site.sh
    Rewrite README.md as the platform's own (two-ESP overview, layout, build,
    wiring), keeping the mandatory C5VRX attribution per AGENTS.md. Trim the
    web-flasher/Pages sections from AGENTS.md, drop the dead Deploy Web Flasher
    dispatch from pr-channel-cleanup.yml, and point firmware_input_hash at
    components/ + firmware/c5/.
    The receive engine (c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
    [BOM.csv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]
2026-10-30 chore: purge upstream C5VRX research and docs not used by the platform
    Remove research/ (upstream RF research, generators and bench data) and the
    upstream research docs under docs/ (FINDINGS, RESEARCH_LEDGER, P64, PHY_*, PR*,
    etc.), keeping only the platform's docs/CHECKPOINT.md and wiring.{svg,dot}.
    Trim the firmware CI (c5vrx5.yml) accordingly: drop the research/*.py
    validations and the numpy venv, the research/legacy_demod "archived kp" step,
    and the host tests that read research/data. Delete the orphaned tests that
    hard-included research/ (test_cn_auto, test_transport_recovery) or were
    research-only validations (test_p64, test_picture_sync, test_iq_lane_fusion).
    Point CONTRIBUTING.md at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
    [blackbox_session24_seconds.csv, partitions.csv, validation.csv]
2026-10-30 docs(agents): update AGENTS.md for the slimmed two-ESP platform
    Repath the engine references (main/ -> components/c5vrx_rx/), rewrite the
    repository-sources inventory and the "at a glance" intro to the components/ +
    firmware/ layout, and drop every dangling pointer to the removed research/,
    legacy/ and upstream docs/ (FINDINGS, RESEARCH_LEDGER, P64, FASTER_CALIBRATION,
    PR212, FLIGHT_LOG, native-agc-v2, level_quality generator). The reuse/
    attribution policy and the realtime receiver invariants are preserved
    verbatim; only the pointers to deleted material were removed.
2026-10-30 feat(race_timing): add the lap/sector timing engine with a host test
    Pure-C, host-tested component for the C6 fleet hub: an ordered-gate model
    (gate 0 = start/finish) that ingests (gate, channel, fleet_ms) crossings and
    keeps, per channel, the current lap's gate times, lap count, last and best lap,
    and per-sector times. No float, no hardware.
    test/test_race_timing.c: two clean laps with sectors, best-lap tracking,
    independent channels, a missed gate, out-of-range/overflow guards, gate-count
    clamping (16 checks).
    Claude-Session: https://claude.ai/code/session_01PHqPqeH7CV2ETkYgGbAQsf
    [test_race_timing.c]
2026-10-30 feat(c6): add the ESP32-C6 master skeleton (local C5 + speaker + web)
    New firmware/c6 (esp32c6): the master set's brain. It links its local C5 over
    UART (link_proto), plays the centralized coin sound on a pass (audio_player,
    the speaker lives here), and exposes a Wi-Fi SoftAP + a minimal admin web
    showing the local gate's C/N, stats and recent passes.
    - c6_link: UART task; HELLO + periodic CONFIG_REQ to the local C5; on EVENT_PASS
    -> store + audio_player_play(coin, channel pitch); on STATS -> store.
    - c6_store: mutex-guarded local status + recent-pass ring.
    - c6_web: SoftAP (channel shared with ESP-NOW later) + GET /api/state + page.
    Build restricted to main's closure (c5vrx_rx is C5-onl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
    [partitions.csv]
2026-10-30 feat(espnow_link,c6): ESP-NOW transport + C6 fleet hub (pairing, timing)
    espnow_link (shared component): carries fleet_proto datagrams over ESP-NOW on
    the C6 AP's fixed channel; decodes off the Wi-Fi callback and dispatches to a
    worker task; peer + broadcast management; self-MAC helper.
    C6 hub (firmware/c6/c6_hub.c): owns the ESP-NOW link, the paired-node table in
    NVS (gate 1.. per node; gate 0 is the local C5), periodic fleet time beacons,
    node liveness, and the race_timing engine. On a PAIR_REQUEST it assigns a gate
    and channel, persists, and replies PAIR_ACCEPT + CONFIG. Every pass — local C5
    (gate 0, via c6_link) or remote GATE_PASS — is timed and sounded centrally.
    A snapshot (node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
    [c6_hub.c, c6_hub.h, c6_link.c, main.c]
2026-10-30 feat(c6): web admin — pairing, gate order, channel, standings
    Extend the C6 admin web into the race-control UI: a pairing toggle, a gate/node
    table (editable gate order and channel per node, with link state and C/N,
    save/remove), live standings per channel (laps, last/best lap, last gate), the
    local gate stats, and a reset-race button. Backed by new hub operations
    (c6_hub_set_node / remove_node / reset_race) that persist to NVS and re-push
    CONFIG to the node; num_gates now sizes from the highest assigned gate.
    C6 builds at 0 warnings for esp32c6.
    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
    [c6_hub.c, c6_hub.h, c6_web.c]
2026-10-30 feat(link_proto,checkpoint): SET_CHANNEL command retunes the C5
    Add link_proto LP_MSG_SET_CHANNEL (bridge -> C5, one RF channel index) so the
    C6/C3 can command the gate's C5 to tune to its assigned channel. The C5's
    checkpoint_link handles it by calling the receiver's existing rf_set_channel();
    this is the operator-approved step where checkpoint moves from reading receiver
    state to commanding a retune (the receive-chain engine itself is unchanged).
    link_proto host test covers the SET_CHANNEL roundtrip (14 checks); the C5 and
    fleet host tests still pass. C5 builds at 0 warnings.
    Claude-Session: https://claude.ai/code/session_01PHqPqeH7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
2026-10-30 feat(c3): fleet node bridge with ESP-NOW uplink and degraded mode
    Rework firmware/c3 into a fleet node. c3_fleet: ESP-NOW to the C6 (on the shared
    AP channel), pairing (PAIR_REQUEST -> PAIR_ACCEPT, persisted in NVS), applies
    the C6's CONFIG (detector tunables + a SET_CHANNEL retune to the local C5),
    tracks fleet time from beacons, and relays the C5's passes as fleet-timed
    GATE_PASS plus periodic NODE_STATUS. c3_link now routes C5 events to registered
    handlers and gained a generic send queue + c3_link_set_channel.
    At boot the C3 keeps its AP up (carrying ESP-NOW) and probes the C6 for
    CONFIG_C3_FLEET_TIMEOUT_MS: if reached it runs as a headless relay; otherwise it
    falls back to the degraded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
    [c3_fleet.c, c3_fleet.h, c3_link.c, c3_link.h, c3_web.c, main.c]
2026-10-30 docs,ci: document the race-timing fleet and build/test it
    Update CLAUDE.md, README.md, docs/CHECKPOINT.md and AGENTS.md for the fleet: the
    ESP32-C6 master, the C3 node/degraded-mode bridge, the fleet_proto / race_timing
    / espnow_link components, SET_CHANNEL retune, and the shared-channel constraint.
    CI (c5vrx5.yml) now builds firmware/c6 (esp32c6) alongside c5/c3 and runs the
    fleet_proto and race_timing host tests next to the others.
    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
2026-10-30 docs: add the fleet architecture diagram and a consolidated pinout
    docs/fleet.svg is a global schema of the elements (C5 gates, C3 nodes, C6
    master, amplifier, admin) and their interactions (UART link_proto, ESP-NOW
    fleet_proto, Wi-Fi web, I2S audio), with the per-link pins. The README gains an
    Architecture section pointing at it and a Pinout section with the C5/C3/C6 pin
    tables (Kconfig defaults, crossed UART, shared ESP-NOW/AP channel); CHECKPOINT.md
    links the diagram.
    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
2026-10-30 feat(c6,c3): two web roles — read-only spectator and authenticated admin
    The C6 admin web and the C3 degraded web now distinguish two user levels:
    spectators read the live standings/status with no login, while mutating actions
    require an admin login. Credentials (CONFIG_*_ADMIN_USER / _PASSWORD) are sent
    as HTTP Basic and checked server-side on every mutation endpoint (pairing, node
    gate/channel, reset on the C6; config/band on the C3) plus a GET /api/auth probe
    — the UI gating is cosmetic, the server check is the gate. An empty password
    disables admin auth. The pages add a login panel and hide admin controls until
    unlocked.
    Both firmwares build at 0 warnings.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
    [c3_web.c, c6_web.c]
2026-10-30 docs: bring CLAUDE.md/README/AGENTS up to date with the fleet
    - CLAUDE.md: new "Fleet (C6 master + C3 nodes)" section (protocols, consolidated
    C5/C3/C6 pinout, SET_CHANNEL retune, centralized sound, the two web roles,
    degraded mode, shared Wi-Fi channel); reframe the intro and the C3 bullet
    (relay when a C6 is reachable, else degraded local web).
    - README: intro no longer says "two-ESP" only — it scales to the fleet.
    - AGENTS.md: CI builds firmware/c5, c3 and c6 (C5 is the released image).
    Docs only; no code change.
    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
2026-10-31 docs: add per-set pin-level wiring diagrams (master, node)
    docs/wiring-master.svg — the master set (C5 gate 0 UART to the C6, C6 I2S to the
    MAX98357A + speaker, C6 Wi-Fi/ESP-NOW). docs/wiring-node.svg — a remote gate
    (C5 UART to the C3, C3 ESP-NOW to the C6, no amplifier). Both show the crossed
    UART pins and note the C6 defaults; the existing wiring.svg stays as the
    standalone single-C5 set. README Architecture and CHECKPOINT link all three.
    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
2026-10-31 feat(c6): temporary "C5 as master" build + per-set C5+C5 diagram
    Until a C6 is available, the master firmware (firmware/c6) can run on a spare
    ESP32-C5: a gate C5 (firmware/c5) UART-wired to a C5 running firmware/c6 built
    for esp32c5, standing in for a C6+C5 set (full link + centralized sound + web,
    no ESP-NOW needed for a single master+gate).
    firmware/c6/sdkconfig.c5.defaults pins the target to esp32c5 and moves the
    amplifier to the proven C5 pins 9/8/7/10 (SD on 10; GPIO 16-22 are the C5 SPI
    flash, so the C6 defaults 18-21 are invalid there). Build:
    (cd firmware/c6 && idf.py -DIDF_TARGET=esp32c5 -DSDKCONFIG=sdkconfig.c5 \
    -DSDKCONFIG_DEFAULTS=sdkconfig.c5.defaults -B build-c5 build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
2026-10-31 docs: fix overflowing C6 label in wiring-master.svg
    The violet C6 line (Wi-Fi/ESP-NOW roles) ran past the box width; split it into
    two shorter centered lines.
    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
2026-11-01 fix(checkpoint): move C5 link RX from GPIO15 to GPIO8
    GPIO15 is not broken out on the ESP32-C5-Zero header, so the previous
    C5<->bridge link RX could not be wired on that board. GPIO8 is a
    receiver-free header pin, free on a fleet gate (video off, no local
    sound). A standalone C5 with local sound uses GPIO11 instead (GPIO8 is
    the amplifier LRC); noted in the Kconfig help and wiring.svg.
    Updates the Kconfig default, the C3/C6 link comments, the
    node fleet diagram and the standalone wiring diagram.
2026-11-01 refactor: name firmware by role — detector / node / master
    Rename the firmware directories by role instead of by chip, since the
    chip no longer identifies the role (the master firmware also runs on a
    C5 in the temporary C5-as-master mode):
    firmware/c5 -> firmware/detector RF receive + pass detection
    firmware/c3 -> firmware/node ESP-NOW node bridge + degraded web
    firmware/c6 -> firmware/master fleet hub: timing + speaker + admin web
    Update every path reference (CI workflow, CMake comments, docs, the
    firmware-input hash tool and the calibration-runtime test). The C5VRX
    engine identifiers (NVS namespace, calibration presets, TAG, the
    released c5vrx5.bin) and the CMake proj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
    [partitions.csv]
2026-11-01 refactor: name firmware binaries by role+chip
    Rename the CMake project names so the built binaries match the
    role-based directories, and so the two master targets are distinct:
    c5vrx5 -> detector-c5 (detector-c5.bin)
    checkpoint_c3 -> node-c3 (node-c3.bin)
    checkpoint_c6 -> master-c6 (esp32c6) / master-c5 (esp32c5 stand-in)
    The master CMakeLists selects its name from IDF_TARGET, so the native
    build yields master-c6.bin and the spare-C5 build yields master-c5.bin.
    The CI release step tracks the new name (detector-c5.bin /
    detector-c5_merged.bin).
    Left unchanged: the C5VRX-5 release-channel identity (c5vrx5-v5.0.N
    tags, c5vrx5-pr-N prereleases, workflow name, concurrency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
2026-11-01 docs: rework C5+C5 and master wiring diagrams
    Update the per-set wiring diagrams and align them with the current
    pins and naming: C5<->bridge link RX on GPIO8, firmware paths by role
    (firmware/detector, firmware/master), and the C5-as-master build command.
2026-11-01 build: add root Makefile + tools/fw.sh (make firmware / make flash)
    A top-level Makefile delegates to tools/fw.sh:
    make firmware build all four images
    make build-<name> build one (detector|node|master|master-c5)
    make flash [FW=<name>] [PORT=<port>] flash one
    make monitor [FW=<name>] [PORT=<port>] serial monitor
    make clean remove build dirs
    flash/monitor fall back to an interactive menu (firmware + serial port,
    auto-listing /dev/tty{ACM,USB}* and /dev/cu.usb*) when FW or PORT is
    omitted. ESP-IDF is sourced from IDF_EXPORT (default
    ~/esp/esp-idf-v6.0.2/export.sh). The master target picks master-c6
    (esp32c6)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
2026-11-01 feat(status_led): pure-C status LED core + host tests
    A single-WS2812 status indicator, split like pass_detector: a pure-C
    state -> colour/pattern machine (components/status_led, host-tested) and,
    later, a bit-banged-over-RMT WS2812 driver + task as ESP glue.
    States: BOOT (yellow blink), HEALTHY (green breathing), DEGRADED (blue
    breathing), PAIRING (magenta double-pulse), ERR_RECOV (red fast blink),
    ERR_FATAL (red solid); a pass latches a brief white flash (priority
    ERR_FATAL > pass > base). Optional bench mode maps C/N to HEALTHY
    brightness. Integer, wrap-safe timing; ~15% default brightness.
    test/test_status_led.c covers each pattern, the pass/fatal priority and
    brightness scaling (added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
2026-11-01 feat(detector): WS2812 status LED on GP29
    ESP glue for status_led: a WS2812 driver over the RMT bytes encoder (no
    external component) + a priority-1 render task started after the splash,
    with thread-safe setters (status_led.h). Kconfig: enable, GPIO (29 on the
    C5-Zero), brightness (~15%), tick, stack.
    Detector wiring (components/checkpoint):
    - on_pass -> white flash, even when the sound is off;
    - the task sets green when the bridge link is alive, blue otherwise,
    from a new checkpoint_link_last_rx_ms() (bridge counts as present
    within 3 s of the last valid frame);
    - an out-of-memory start sets the red fatal state.
    So the C5 can sense the link, the C3 (c3_link) now sends a periodic
    HELLO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
2026-11-01 fix(detector): disable status LED, onboard WS2812 is a receiver pin
    The C5-Zero's onboard WS2812 is wired to GPIO27, which is one of the
    receiver's IQ-loopback pins (RF_IQ_GPIO_NUMS). Pointing the RMT WS2812
    driver at it boot-loops the detector (the pin is reserved for the C/N
    chain) and would break the receive chain anyway -- which comes first.
    The Waveshare pinout's "GP29" for the LED is also wrong: the ESP32-C5
    has no GPIO29 (GPIO0..28 only).
    So the detector keeps no status LED (CONFIG_STATUS_LED_ENABLE=n); the
    status_led core and its checkpoint hooks stay but are inert there. The
    feature belongs on the node (C3-Zero, GPIO10) and master (C6-Zero,
    GPIO8), whose onboard WS2812 pins are fre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
2026-11-01 fix(detector): build for 4 MB flash (C5-Zero)
    The Waveshare ESP32-C5-Zero has 4 MB flash, but the detector image was
    built for 8 MB with a partition table spanning ~4.8 MB. On a 4 MB part
    the flash probe aborts in early system init ("Detected size(4096k)
    smaller than the binary image header(8192k)") and the board boot-loops
    before reaching the app.
    Switch to CONFIG_ESPTOOLPY_FLASHSIZE_4MB and shrink the factory
    partition 0x300000 -> 0x1C0000 (the app is ~1.26 MB; 31% free); the
    1.5 MB flightlog is unchanged and the table ends at 0x350000, within
    4 MB. A 4 MB image also boots on an 8 MB part, so one binary covers both
    the C5-Zero and 8 MB C5 boards (XIAO).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
    [partitions.csv]
2026-11-01 fix(detector): drop flightlog partition to fit the no-PSRAM RAM budget
    On a no-PSRAM ESP32-C5 (e.g. the Waveshare C5-Zero / C5-LCD-1.47, 4 MB)
    the flight-log logger task (3072 B, created at boot by
    components/c5vrx_rx/flightlog.c before the receiver's gain_fast task,
    also 3072 B) and gain_fast cannot both fit the boot heap: gain_fast
    fails with ESP_ERR_NO_MEM (receiver.c) and the board reboots.
    Remove the flightlog partition so flightlog.c degrades to "partition
    missing -> off" and never spawns its task, freeing that 3072 B for the
    receiver; factory grows 0x1C0000 -> 0x200000. This matches the proven
    FPV-5.8-Detector config. The detector now boots to "ready" on a 4 MB
    no-PSRAM C5 (verified: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
    [partitions.csv]
2026-11-01 feat(node): WS2812 status LED on GP10
    Wire status_led into the C3 node (Waveshare C3-Zero onboard WS2812 on
    GPIO10). The base state comes from the fleet: magenta while pairing,
    green when the master is alive (a fleet message within 5 s), blue in the
    degraded local-AP fallback, and red if the C5 UART link goes silent
    (>3 s without a frame). A C5 pass flashes white (relay or degraded).
    c3_fleet tracks the master's last-seen time and the degraded flag and
    exposes c3_fleet_led_base(); the c3_link task pushes the base every
    ~100 ms (overriding with the C5-link-lost red). status_led_start() runs
    right after NVS so boot shows yellow. GPIO set in sdkconfig.defaults.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
2026-11-01 feat(status_led): boot self-test (red/green/blue)
    The render task flashes red, then green, then blue (~0.4 s each) before
    entering the state loop, so bringing up a new board makes the WS2812's
    GPIO, wiring and colour order obvious at a glance -- and distinguishes it
    from a separate power LED.
2026-11-01 feat(master): WS2812 status LED on GP8
    Wire status_led into the C6 master. Base state from the fleet hub
    (c6_hub beacon task, every 2 s): magenta while pairing with no gates
    yet, blue if a paired gate dropped offline, green otherwise. Any gate's
    pass (local C5 or a remote node, via record_pass) flashes white.
    GPIO8 on the C6-Zero (sdkconfig.defaults); the C5-as-master variant uses
    GPIO27 (sdkconfig.c5.defaults) -- free there because that build runs no
    receiver, unlike the detector. status_led_start() after NVS; both the
    esp32c6 and esp32c5 builds verified.
2026-11-01 build: firmware-variant model + `make variants` listing
    Make the per-role variant scheme explicit in tools/fw.sh: a role's plain
    name (detector/node/master) is its default board; "<role>-<tag>" is a
    board variant that builds in its own dir with its own sdkconfig, so
    variants never clobber. `make variants` (fw.sh variants) lists the FW=
    names and their boards. Adding a variant = one resolve() case + a
    sdkconfig.<tag>.defaults overlay in the role dir.
2026-11-01 build: detector board variants + rename master-c5 -> master-wave-c5
    Generalize the per-role variant system in tools/fw.sh. A variant's
    config is now an OVERLAY: SDKCONFIG_DEFAULTS is a ";"-separated list
    (sdkconfig.defaults first, then the variant's own file), so the detector
    base RAM/Wi-Fi/PHY tuning is never duplicated. resolve() carries the
    chip, the sdkconfig name, the defaults list and a per-variant build dir;
    the idf.py args are quoted so the ";" lists survive.
    New FW= names:
    detector ESP32-C5-Zero / C5-LCD, 4 MB no-PSRAM (default)
    detector-xiao-c5 XIAO ESP32-C5HR8, 8 MB + PSRAM, flight log on
    detector-wave-c5-lcd Waveshare ESP32-C5-LCD-1.47, 4 MB no-PSRAM
    m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
    [partitions.flightlog.csv]
2026-11-01 docs: document the status LED scheme in CHECKPOINT.md
    Add a "LED de statut" section: the status_led component (pure-C core +
    RMT WS2812 driver, boot R/G/B self-test, priority 1, ~15%), the onboard
    pins (node GPIO10, master GPIO8 / C5-as-master GPIO27), the state ->
    colour table, the per-role behaviour (node, master), and the no-colour
    cases (detector: GPIO27 is a receiver pin; C3 SuperMini: no WS2812).
2026-11-01 docs: slim CLAUDE.md, point LED and detector detail to CHECKPOINT.md
    CLAUDE.md is loaded every session, so keep it lean. The full status-LED
    scheme and the detector parameter table now live in docs/CHECKPOINT.md;
    CLAUDE.md keeps the agent-critical summary (state machine, the
    detector-has-no-LED / GPIO27 invariant, PREFS_VERSION) and points to the
    detailed sections. 246 -> 209 lines, no information lost.
    AGENTS.md is left as-is: it is upstream C5VRX policy and should stay
    aligned with upstream rather than being split into docs/.
2026-11-01 docs: slim CLAUDE.md Wiring + Fleet to summaries + pointers
    Wiring keeps the amp/UART pins, the pin_owner boot check and the GPIO
    map that follows; the full per-board pinout is README "Pinout" +
    docs/wiring*.svg. Fleet keeps the architecture, the protocol list and
    the pinout table; the in-depth protocols, pairing, web roles, degraded
    mode and the C5-as-master build move to docs/CHECKPOINT.md (which
    already had them). CLAUDE.md 246 -> 181 lines.
2026-11-01 docs: split CHECKPOINT.md into topic pages
    docs/CHECKPOINT.md was ~290 lines; split it into an index plus five
    focused pages so no single doc is overly long:
    docs/detector.md detector operation + console parameters
    docs/no-video-audio.md video-off output + optional audio wiring
    docs/fleet.md C6 master + C3 nodes (protocols, pairing, web)
    docs/status-led.md WS2812 state -> colour scheme per board
    docs/bench.md bench procedure (build/flash + A/B/A)
    CHECKPOINT.md keeps the intro, the component table, the two-ESP platform
    overview and links to the pages. CLAUDE.md pointers now target the
    specific page (docs/detector.md, docs/status-led.md, docs/f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
2026-11-01 docs: translate the docs/ pages to English
    CHECKPOINT.md and its five topic pages (detector, no-video-audio, fleet,
    status-led, bench) were the only French docs; translate them to English
    to match the rest of the repo, keeping the structure, tables, code refs,
    links and the status-LED colour emoji.
2026-11-01 feat(master): optional boot chime to test the speaker
    Add CONFIG_C6_BOOT_CHIME (default n): when set, the C6 plays one coin
    sound at startup (at a gentle 25% volume), right after audio_start(), to
    confirm the centralized speaker/amplifier works. It is a no-op unless
    the audio is built (CONFIG_AUDIO_PLAYER_ENABLE + coin.pcm), so the
    default build is unchanged.
    sdkconfig.demo-audio.defaults is a ready overlay (audio on + chime on)
    for a quick speaker test; build it in its own dir, e.g. for the C5-Zero
    stand-in master:
    idf.py -DIDF_TARGET=esp32c5 -DSDKCONFIG=sdkconfig.c5-demo \
    -DSDKCONFIG_DEFAULTS="sdkconfig.c5.defaults;sdkconfig.demo-audio.defaults" \
    -B build-c5-demo build
    It need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
2026-11-01 build: local sdkconfig.local.defaults override (passwords, audio)
    Add a per-firmware sdkconfig.local.defaults for local, uncommitted
    settings — the Wi-Fi AP / admin-web passwords, or enabling audio and the
    boot chime — so real secrets never land in the committed defaults.
    tools/fw.sh appends it last in the SDKCONFIG_DEFAULTS chain (so it wins),
    and it is gitignored. Also gitignore the generated coin.pcm.
2026-11-01 feat(master): set the centralized audio volume from the admin web
    Add a volume control to the C6 admin web: a 0..100% slider (admin-only)
    that POSTs /api/volume. c6_hub_set_volume() applies it via
    audio_player_set_volume() and persists it in NVS (key "volume"); it is
    loaded and applied at boot (volume_apply_saved) and exposed in the state
    snapshot so the page shows the current value. Volume is global (the one
    centralized speaker). Works whether or not audio is built (the setter is
    a no-op path when disabled).
2026-11-02 fix(fw.sh): don't abort resolve when there is no local override
    The local-override line used `[ -f ... ] && DEFAULTS=...`; under `set -e`
    the false test (no sdkconfig.local.defaults, the normal case) made the
    compound command return non-zero and aborted resolve(), breaking every
    `make build-*` / `make flash`. Use an `if` instead.
2026-11-02 feat(master): show master + per-node health in the admin web
    Enrich the state snapshot and the web: the master now reports its uptime
    and free internal heap (shown in the "Master & local gate (0)" card),
    and each node row gains a "Seen" column (seconds since its last ESP-NOW
    frame, from last_seen_ms + the master uptime) alongside the existing
    online/offline and C/N. node state is also exposed in the JSON.
2026-11-03 refactor(c5vrx_rx): prune the engine for the video-off detector
    The detector never shows a picture, so drop the upstream video menu/OSD/
    splash (menu.c, menu_ui.c, menu_raster.c with their font, logo and DAC-test
    headers), the field experiments (experimental*.c), the flight log
    (flightlog.c) and the bench labs (sense_lab*.c, calibration_bench.c).
    menu_stub.c and pruned_stubs.c stand in for the symbols the kept code
    calls, with today's video-off behaviour: the splash flag still gates
    BOOT_PHASE, the menu still owns TX during calibrations, the experiments
    stay at baseline (experimental_transfer_active() keeps its lane test).
    The receive chain (rf, transport, receiver, gain, agc, *.bsasm) and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
    [partitions.csv, partitions.flightlog.csv]
2026-11-03 feat(fleet): remote C5 health and commands, report-only detector
    Production has no USB console on a detector, so its bridge now does what
    the console did:
    - link_proto v2: STATS carries the C5's health (calibration needed or
    running, gain, passes, uptime, lowest free heap, transport faults,
    firmware id) instead of the audio counters; a new COMMAND runs the
    console's B (full calibration), F (quick calibration) or a reboot.
    - fleet_proto v2: NODE_STATUS relays that health with a sequence number,
    and a new COMMAND goes master -> node -> C5.
    - C6 admin web: per-gate health, Cal B / Cal F / Reboot and "calibrate all
    gates", guarded: a confirmation, then a refusal unless forced when a g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
    [c3_fleet.c, c3_fleet.h, c3_link.c, c3_link.h, c3_store.h, c3_web.c, c3_web.h, c6_hub.c]
2026-11-03 docs: record the pruned fork, the report-only detector and remote gate control
    README, AGENTS.md and CLAUDE.md now list every change to the upstream
    engine (6bc9e4b), as the attribution policy asks: the pruned modules, the
    stubs, transport.c's VIDEO_OUTPUT pin routing and console.c. docs/
    describes the detector with no local output, the gate health and remote
    commands (docs/fleet.md), and the actual config flow between C3 and C5.
    It drops the standalone C5-with-amplifier wiring (docs/wiring.svg/.dot);
    docs/fleet.svg now shows the C5 UART on GPIO 6/8 (it said 6/15).
2026-11-04 feat(web): password-only admin toggle on the C3 and C6 pages
    The header's spectator/admin switch opens a password dialog (no
    username); the password goes out as HTTP Basic with an empty user-id
    and is checked on the ESP. Switching back to spectator forgets it.
    CONFIG_C6_ADMIN_USER and CONFIG_C3_ADMIN_USER are removed.
2026-11-04 fix(web): bound the admin and Wi-Fi passwords instead of opening access
    - Admin password (C3 and C6): 128 bytes max, enforced at build time. The
    expected Authorization header is sized from that limit; an encoding
    failure now locks admin actions instead of disabling auth (a password
    over ~93 bytes used to open every admin action silently). The header
    buffer keeps one spare byte because ESP-IDF truncates a value of
    exactly the buffer's size and still returns ESP_OK.
    - Wi-Fi SoftAP passphrase (C3 and C6): empty (open AP) or 8 to 63
    characters, enforced at build time; 1 to 7 characters used to leave
    the AP open and more than 63 were truncated.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
    [c3_web.c, c6_web.c, main.c]
2026-11-04 feat(web): keep only a salted SHA-256 of the admin password in the firmware
    main/CMakeLists.txt (C3 and C6) reads CONFIG_*_ADMIN_PASSWORD from the
    build's sdkconfig.json (byte-exact), fails the build above 128 bytes and
    generates admin_hash.h with SHA-256("fpv58-checkpoint/<board>:" password),
    a fixed 32 bytes. The C code no longer references the password, so it
    is gone from the .bin. At each admin request the Basic header is
    decoded right after the salt and checked with psa_hash_compare
    (hardware SHA, constant-time); an empty password still disables admin
    auth. The precomputed header buffer is gone (.bin 320 B smaller).
    [c3_web.c, c6_web.c]
2026-11-04 feat(web): sign admin requests (HMAC-SHA256, session counter, PBKDF2 key)
    The C3/C6 admin password no longer crosses the Wi-Fi. New component
    components/web_auth:
    - build time (project_include.cmake, admin_key.py): K = PBKDF2-HMAC-SHA256
    (password, salt random per configure, 200000 iterations), read from
    sdkconfig.json; admin_hash.h holds K, the salt and the iteration count.
    The 128-byte password limit is gone.
    - page (www/auth.js, served at /auth.js): pure-JS SHA-256/HMAC/PBKDF2
    (crypto.subtle needs HTTPS); login opens a session (POST /api/session)
    and derives K once; each admin request carries X-Auth-Session,
    X-Auth-Seq and X-Auth-Sig = HMAC(K, sid, seq, method, path, body).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
    [c3_web.c, c6_web.c, test_web_auth.c]
2026-11-05 feat(tools): mock web server to edit the C3/C6 pages without a board
    tools/web_mock.py (make web-master / web-node) serves the real pages
    from disk, so a browser reload shows an edit with no build or flash.
    /api/* answers like the firmware on a simulated race, admin actions
    take effect, signed requests are checked as on the ESP and bodies over
    the firmware's buffers are refused. test/test_web_mock.py (also in CI)
    holds its /api/state fields, routes and buffers to the C code.
2026-11-05 feat(checkpoint): hop bench, can one C5 scan Raceband
    Console K then s (bench only, components/checkpoint/hop_bench.c): owns
    the receiver like scan() and times several ways of hopping between R1
    and R8, each step on its own, the settling of the IQ power, and the
    refresh a scan would get. The protected receive chain is not edited;
    the direct hops call libphy past rf.c, operator-approved, on this bench
    only. hop_stats.h holds the statistics, host-tested.
    Board result (docs/bench.md, GitHub issue #1): phy_set_freq() drops the
    forced gain, and forcing it again is enough. That hop takes 0.89 ms and
    reads like a full retune, about 88 Hz per channel over 8 channels.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
    [checkpoint.c, hop_bench.c, hop_bench.h, hop_stats.h, test_hop_stats.c]
2026-11-05 feat(checkpoint): Raceband scan prototype on the console
    K then S (bench only) loops the hop bench's fastest hop over R1-R8 with
    one IQ power window per channel, keeps the last 20 s in a heap ring and
    prints them at the end; K then g/G sets its gain. Channels are read
    across the band, so what follows a strong channel in time is never its
    neighbour in frequency. tools/scan_analyze.py reads the recording out
    of the log and lists the passes.
    First board result: 88.8 Hz per channel, no window lost, and 4 hand
    passes out of 4 found on the right channel, 12 dB over the resting
    level, with one VTX. Three weak false passes remain, two of them from a
    residue of the previous channel in the first read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
2026-11-05 feat(checkpoint): select the C5-Zero's antenna (GPIO 26)
    The board's switch was never driven, so anything on the IPEX connector
    was ignored: GPIO 26 high is the IPEX connector, low the onboard
    antenna. It stays undriven by default, since other boards use that pin
    otherwise. K then i switches it on the bench, and
    CONFIG_CHECKPOINT_ANTENNA_IPEX boots on the IPEX connector before the
    radio starts, so the calibration sees that antenna. On the board,
    unplugging the IPEX antenna now drops the VTX by over 30 dB, against
    1-2 dB before. docs/bench.md keeps the hardware attenuation options for
    a sharper pass point later.
2026-11-06 fix(checkpoint): wait out the residue after a scan hop
    The channel read right after a strong one showed it about 8 dB down.
    It followed the reading order, not the frequency: R7 then R3 after R6,
    R8 after R4. K then z (bench only) times it: strongest channel to the
    quietest, a delay, the IQ power of four quarters of a window, against
    the same hop from a quiet channel. On the board nothing is left from
    1 ms on, so the scan now waits 1 ms after each hop, from about 88 Hz to
    about 57 Hz per channel.
    Its default gain goes to 24: at 40 the onboard antenna fills the other
    channels with bursts when the drone is close. tools/scan_analyze.py
    takes a channel's rest from its low levels, since a VTX hel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
    [checkpoint.c, hop_bench.c, hop_bench.h, scan_analyze.py]
2026-11-07 feat(race_timing): each channel's last laps, a reset per channel, a local clock
    The engine kept the lap in progress and the last and best lap, which
    cannot fill a results table. It now keeps each channel's last RT_HISTORY
    laps, 10, with the time into the lap at each gate, read with
    rt_recent_lap(). rt_reset_channel() clears one channel's times and lap in
    progress and leaves it tracked, with last_cross_ms still telling when it
    was last seen.
    rt_clock_to_fleet() puts a board's own timestamps on the fleet clock, for
    a board with no beacons: the master's own C5 is one.
    [test_race_timing.c]
2026-11-07 feat(checkpoint): sweep R1-R8 in production, no channel to choose
    A gate no longer listens to one channel. The C5 hops R1 to R8 for as long
    as it runs, about 57 Hz per channel, and reports a pass with the channel
    it was seen on, so nobody picks a channel. It also ends a master's C5
    sitting on A1, since nothing ever tuned it.
    scan_detector.c turns each channel's IQ power into a rise above that
    channel's own rest and runs one pass detector per channel; the rest is
    learned over the first 3 seconds, with no passes reported meanwhile.
    scan_hop.c keeps the hop the benches proved, and owns the receiver like
    scan() does, giving it back within one sweep for a calibration or a
    console bench. Producti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
    [c3_fleet.c, c3_link.c, c3_link.h, c3_store.c, c3_web.c, c6_hub.c, c6_hub.h, c6_web.c]
2026-11-07 feat(web): simple view, channel status and last results on the C6 page
    The page is there so spectators can see the results, so it now opens on
    the standings and the last results. The advanced toggle adds the
    channels, the gates and the race controls; it changes the view only, and
    each device remembers its choice.
    The standings show each channel online while a pass is under 30 s old,
    with when it was last seen in a bubble on the badge.
    Last results (GET /api/results) has a column per channel with its last
    10 laps. A click on a row opens the lap numbers and the sectors, the
    pause toggle holds the table with a badge counting the laps each channel
    is behind, and an admin can reset one channel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
    [c6_hub.c, c6_hub.h, c6_web.c, test_web_mock.py, web_mock.py]
2026-11-07 feat(hardware): carrier boards for the node and the master
    Two 2-layer boards replace the wiring of a set: a C5-Zero with a C3-Zero,
    and a C5-Zero with a C6-Zero and a MAX98357A breakout. Every USB-C sits on
    the same edge, for flashing and debugging, and solder pads take the power.
    The C5-Zero's and C3-Zero's 5V pin is the USB VBUS itself, so a diode on
    each side keeps a supply on the pads off the PC's port and keeps two
    cables apart, which also covers swapped power wires. A module can then
    run while the other is off, so 1 kOhm on each UART line holds the current
    into the sleeping one's pin.
    A notch leaves nothing under the C3's and C6's antennas, and the C5's
    antenna and IPEX connector ha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
    [checkpoint-master.kicad_pcb, checkpoint-node.kicad_pcb]
2026-11-07 chore(ci): name the workflow and build variables after this project
    The firmware workflow still carried the C5VRX-5 name on a derivative, so
    it becomes checkpoint.yml, "FPV 5.8 Checkpoint Build", with its detector
    step, artifact and concurrency group renamed to match. On GitHub it shows
    up as a new workflow; the old entry keeps its past runs.
    C5VRX5_VERSION and C5VRX5_COMMIT become CHECKPOINT_VERSION and
    CHECKPOINT_COMMIT. That touches the engine's console.c and CMakeLists.txt,
    both already modified here, and AGENTS.md lists the rename with them. The
    receive chain files are unchanged.
2026-11-07 feat(hardware): printed 5.8 GHz quasi-Yagi antenna, V1 and V2
    A directive antenna for the Raceband, the one docs/bench.md left for
    later: a gate that sees the drones in front of it gets a sharper pass
    peak. It reaches a C5-Zero through its IPEX connector. Qian/Itoh topology
    on 1.6 mm FR-4, 34 x 47 mm, from an edge-launch SMA through a 0402 PI
    footprint and a 180 degree delay-line balun to a dipole and two directors.
    gen_qyagi.py is its source. Each run writes the zip, reads it back with
    gerbonara, stops if a layer, the drill file or the board size does not
    come back, and renders the preview.
    V1 is on order, and its zip is kept as the record of it. V2 comes from
    what the script's review fou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
2026-11-07 fix(node): only its own master counts, and a C5 that never spoke is an error
    A node took any master's beacon as its fleet being reachable. Every master
    broadcasts them, so an unpaired node stopped asking to pair after a
    second, and one paired with another master, the earlier C5-as-master for
    instance, relayed to nobody. Both said "C6 reached" and then nothing.
    Beacons now count only from the paired master, so such a node falls back
    to degraded mode, as documented, and says why.
    The status LED went red only if the C5 fell silent after speaking. A C5
    on an older protocol, or miswired, never speaks, and the LED stayed
    green; it now turns red after 3 s.
    A relay node is otherwise quiet, so it l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
    [c3_fleet.c, c3_link.c]
2026-11-07 fix(status_led): RGB byte order on the C3-Zero and C6-Zero
    The driver always sent GRB, WS2812's usual order. Waveshare's FAQ for the
    C3-Zero and the C6-Zero says their onboard LED takes RGB: there, red and
    green were swapped from the start. A healthy board read red, and the fast
    red blink of a silent C5 read as green, which hid exactly the fault being
    looked for.
    CONFIG_STATUS_LED_RGB_ORDER picks the order. The node and master firmware
    set it; the C5-as-master leaves it off, as its FAQ says nothing. The boot
    self-test shows the order: it must start on red. Checked in the built
    images but not on a board yet.
    [status_led_esp.c]
2026-11-07 feat(hardware): bill of materials for the node, master and antenna
    hardware/BOM.csv lists each board's parts with an order reference:
    Waveshare SKUs for the modules, with or without headers, Adafruit's
    MAX98357A, and LCSC parts for the SS34 diodes (SMA package) and the
    0805 and 0402 resistors. The antenna's edge-launch SMA has no reference:
    its footprint is still generic, and a connector picked now might not fit
    the V1 boards on order.
    test/test_pcb.py checks the BOM against the node and master boards: a
    part missing, an extra part or a wrong count fails it. It does not cover
    the antenna.
    [BOM.csv]
